parasgidd/avsdpll_3v3/Documents/pre layout final report.pdf

# PLL

# Final Report

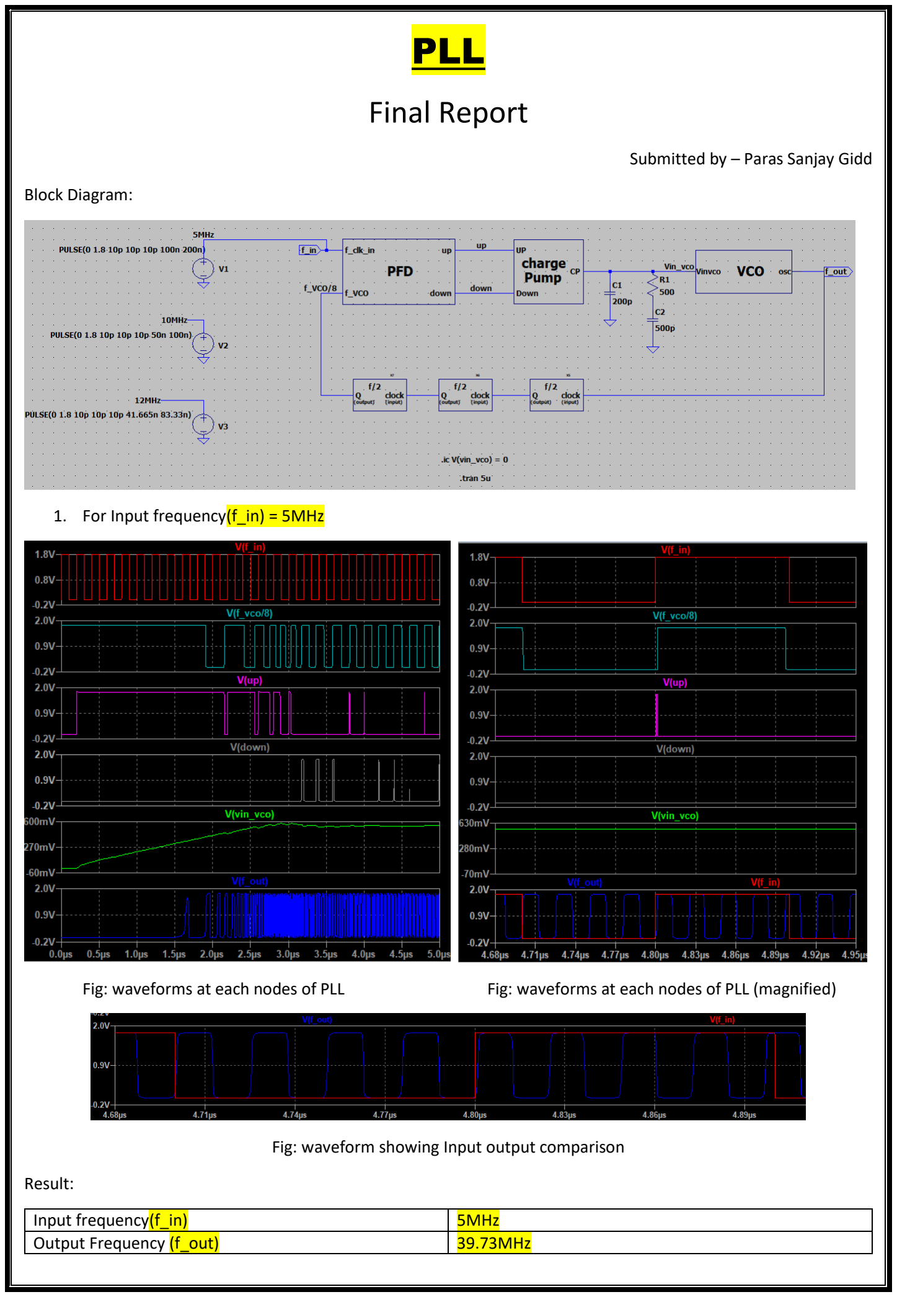
[picture p20: page 1]

Submitted by – Paras Sanjay Gidd

Block Diagram:

1. For Input frequency(f_in) = 5MHz
Fig: waveforms at each nodes of PLL | Fig: waveforms at each nodes of PLL (magnified)

Fig: waveform showing Input output comparison

Result:

Input frequency(f_in) | 5MHz
Output Frequency (f_out) | 39.73MHz

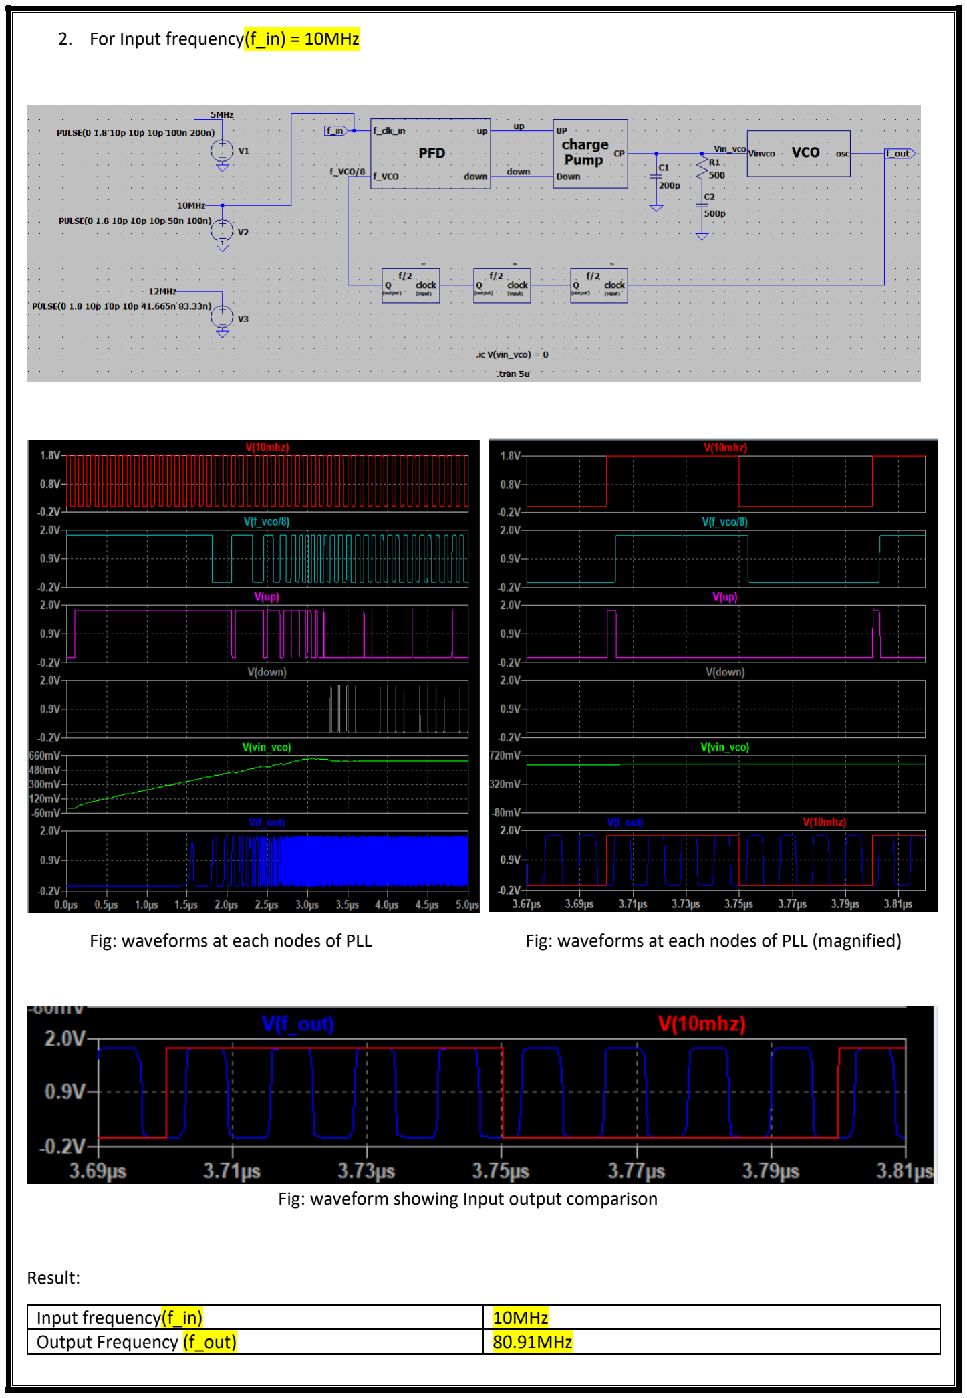
[picture p21: page 2]

2. For Input frequency(f_in) = 10MHz
Fig: waveforms at each nodes of PLL | Fig: waveforms at each nodes of PLL (magnified)

Fig: waveform showing Input output comparison

Result:

Input frequency(f_in) | 10MHz
Output Frequency (f_out) | 80.91MHz

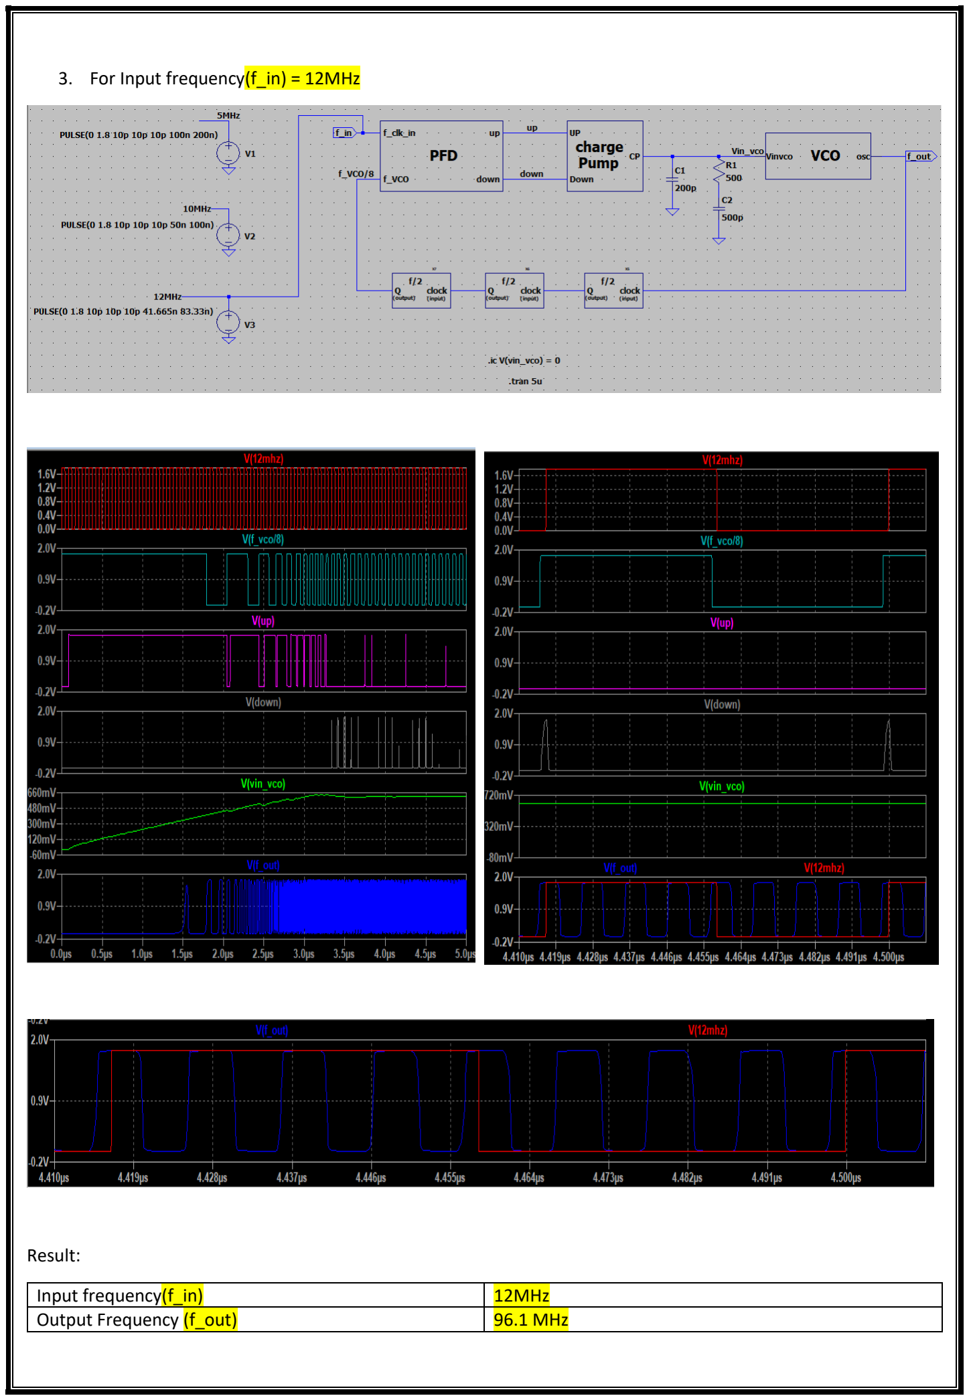
[picture p22: page 3]

3. For Input frequency(f_in) = 12MHz

Result:

Input frequency(f_in) | 12MHz
Output Frequency (f_out) | 96.1 MHz
