parasgidd/avsdpll_3v3/images/block_diagram.png

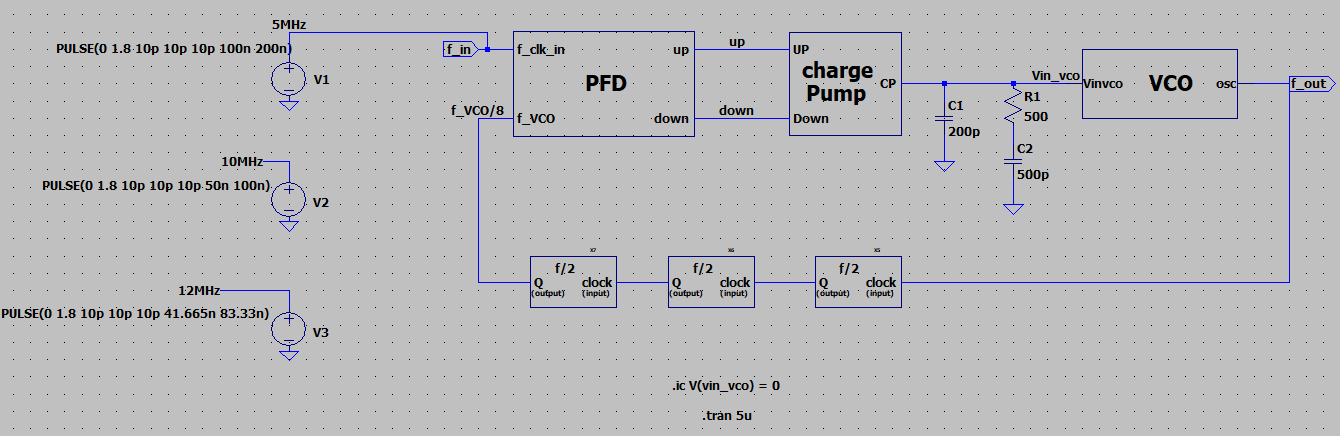
images/block_diagram.png
