parasgidd/avsdpll_3v3/images/LTS_op_wave_5Mh.jpg

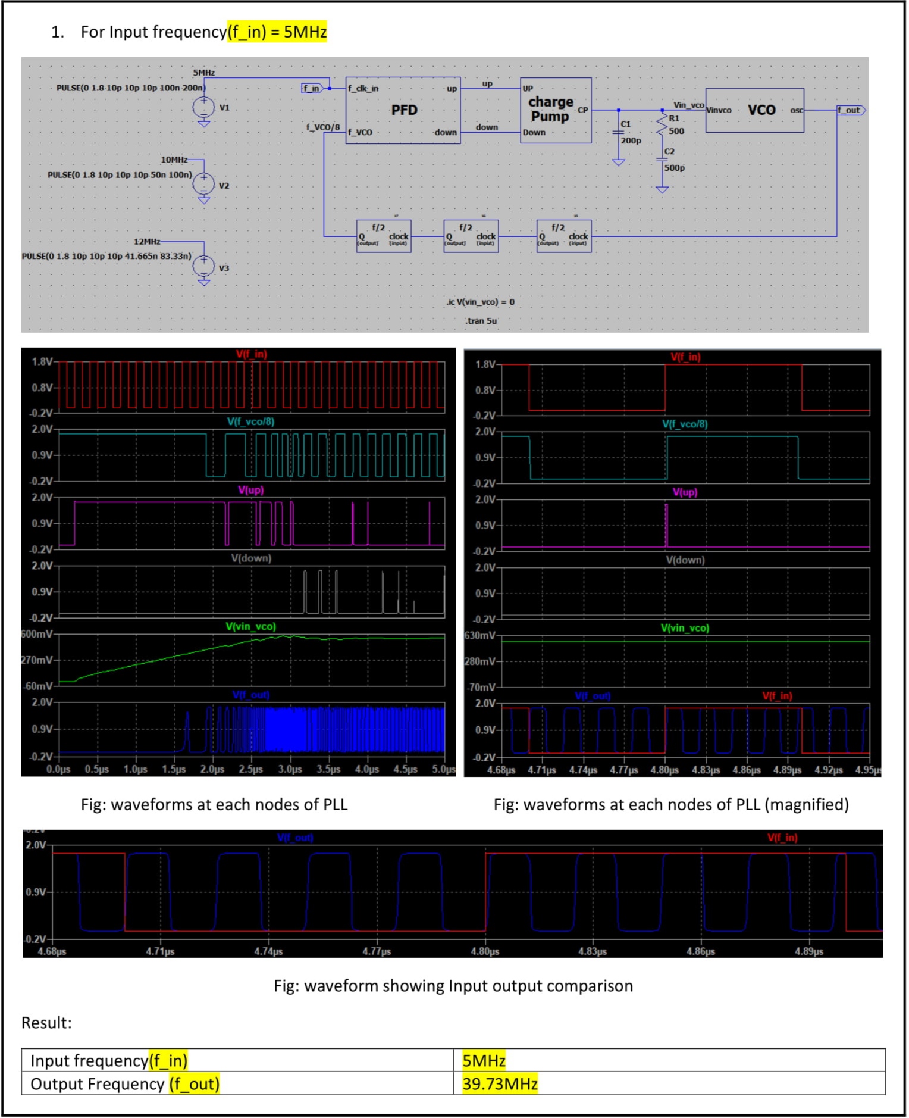
images/LTS_op_wave_5Mh.jpg
