parasgidd/avsdpll_3v3/images/LTS_op_wave_10Mh.jpg

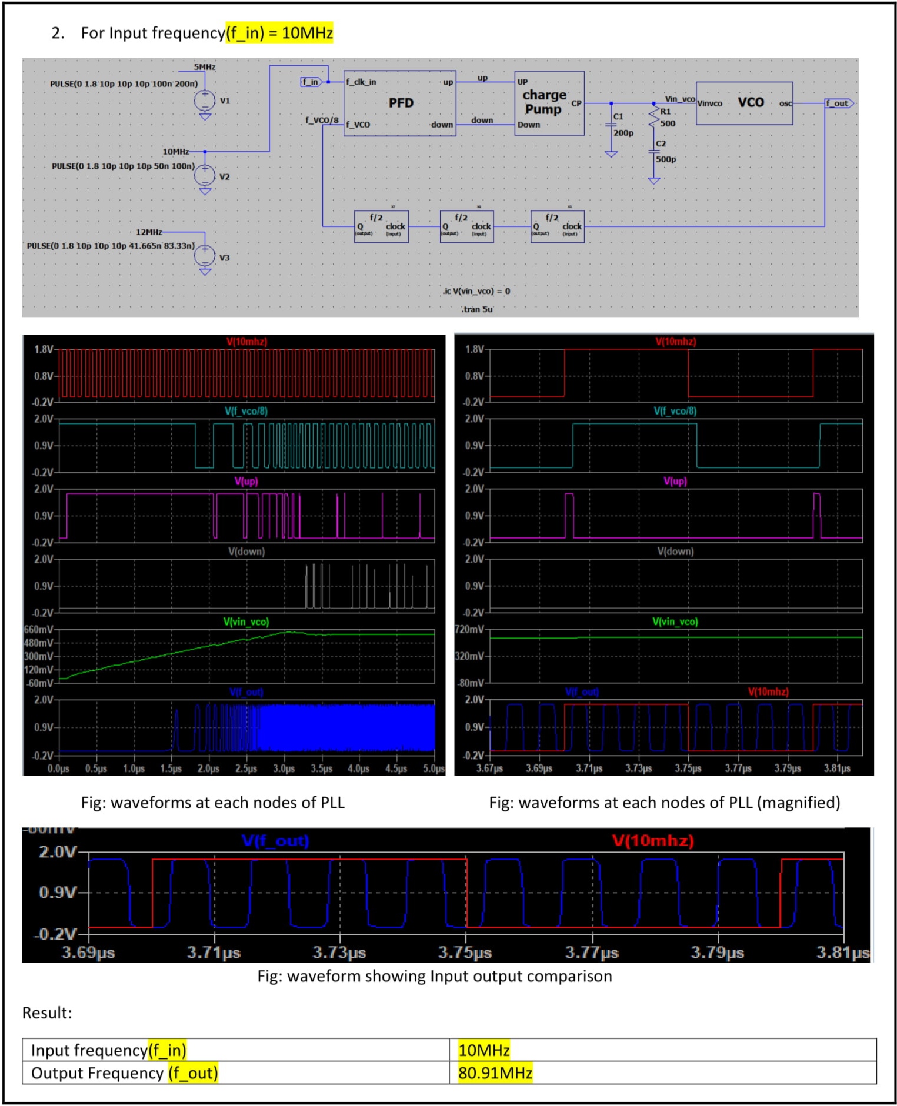
images/LTS_op_wave_10Mh.jpg
