parasgidd/avsdpll_3v3/images/LTS_op_wave_12Mh.jpg

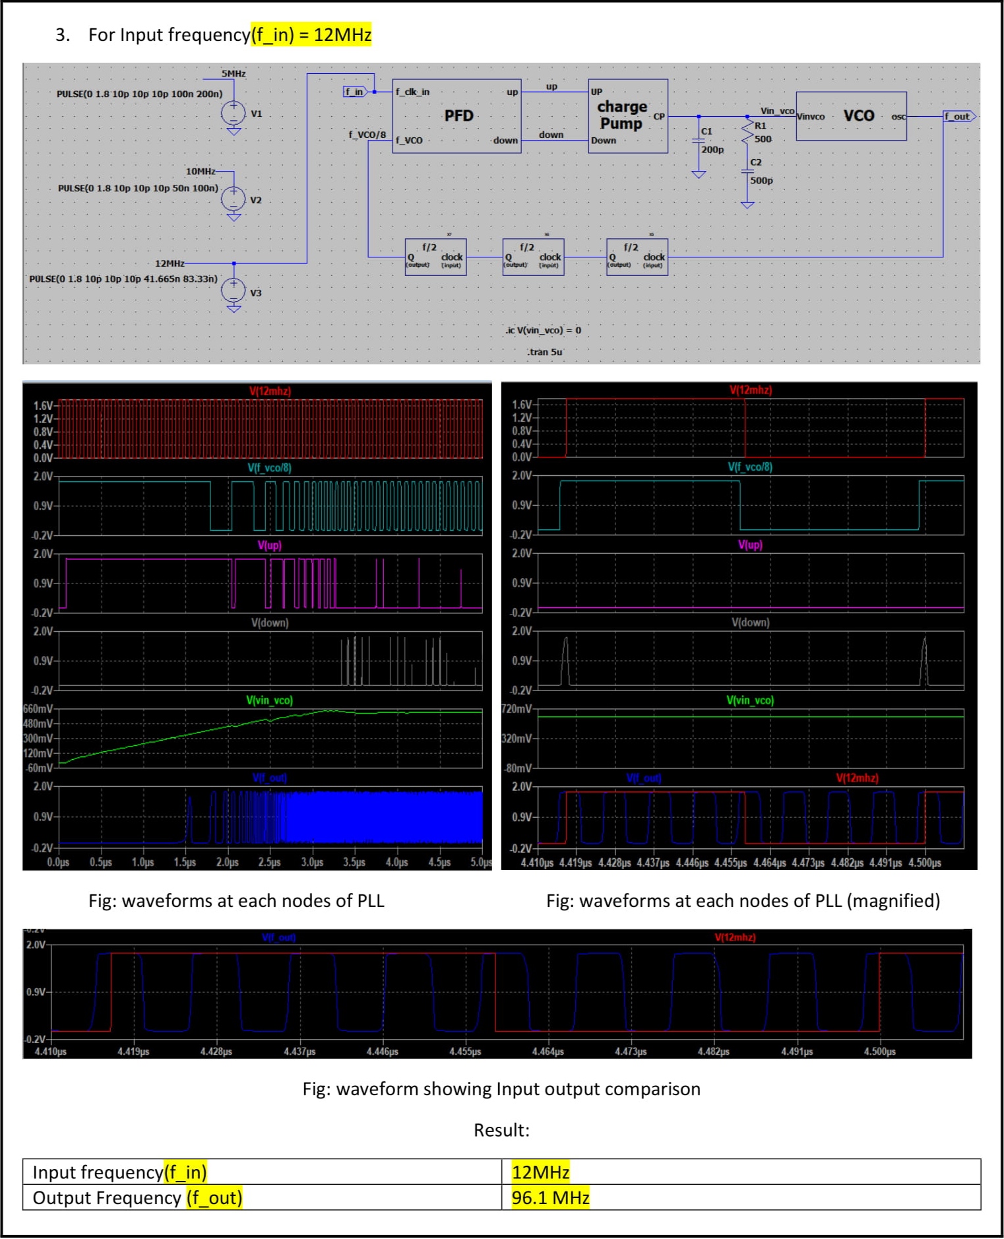
images/LTS_op_wave_12Mh.jpg
