parasgidd/avsdpll_3v3/images/waveforms_all_5M_z.png

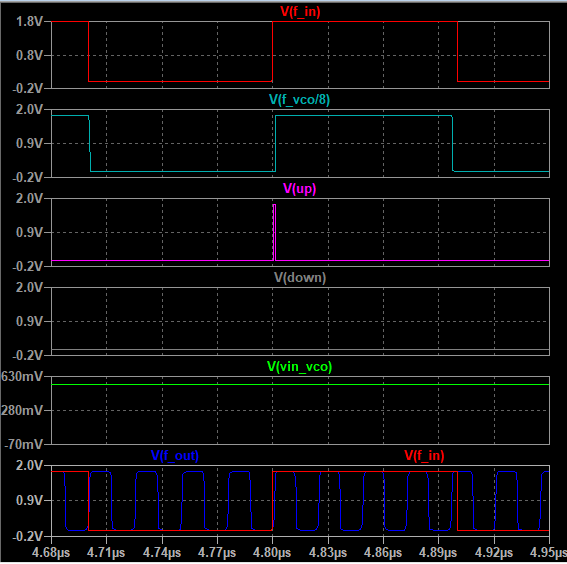
images/waveforms_all_5M_z.png
