parasgidd/avsdpll_3v3/Documents/avsdpll_3v3.pdf

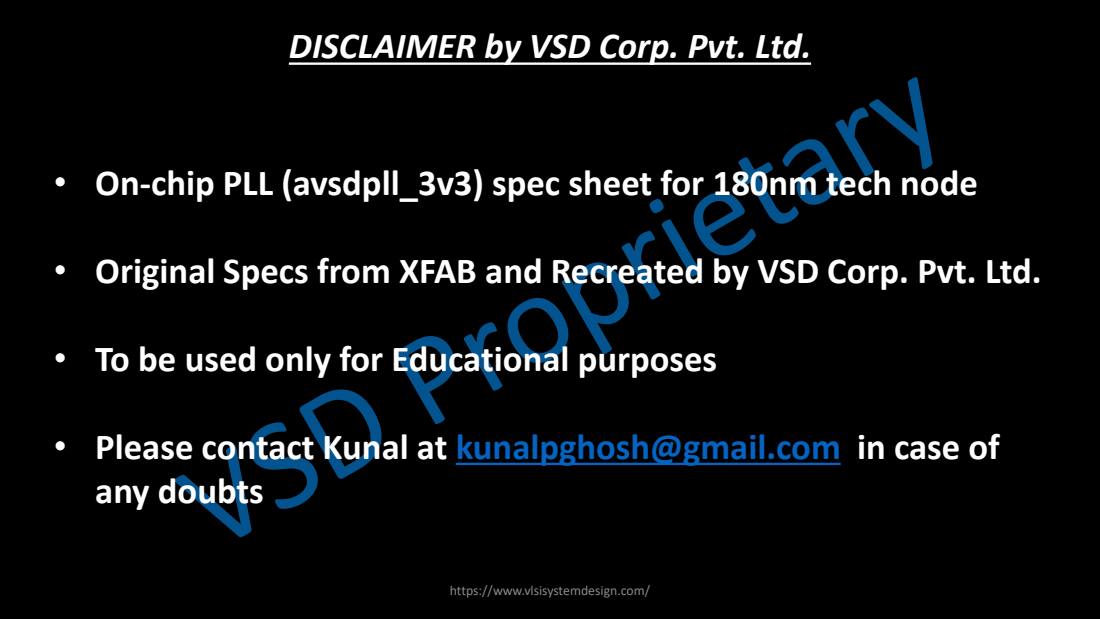
[picture p28: page 1]

DISCLAIMER by VSD Corp. Pvt. Ltd.

• On-chip PLL (avsdpll_3v3) spec sheet for 180nm tech node

• Original Specs from XFAB and Recreated by VSD Corp. Pvt. Ltd.

• To be used only for Educational purposes

• Please contact Kunal at kunalpghosh@gmail.com in case of
any doubts

https://www.vlsisystemdesign.com/

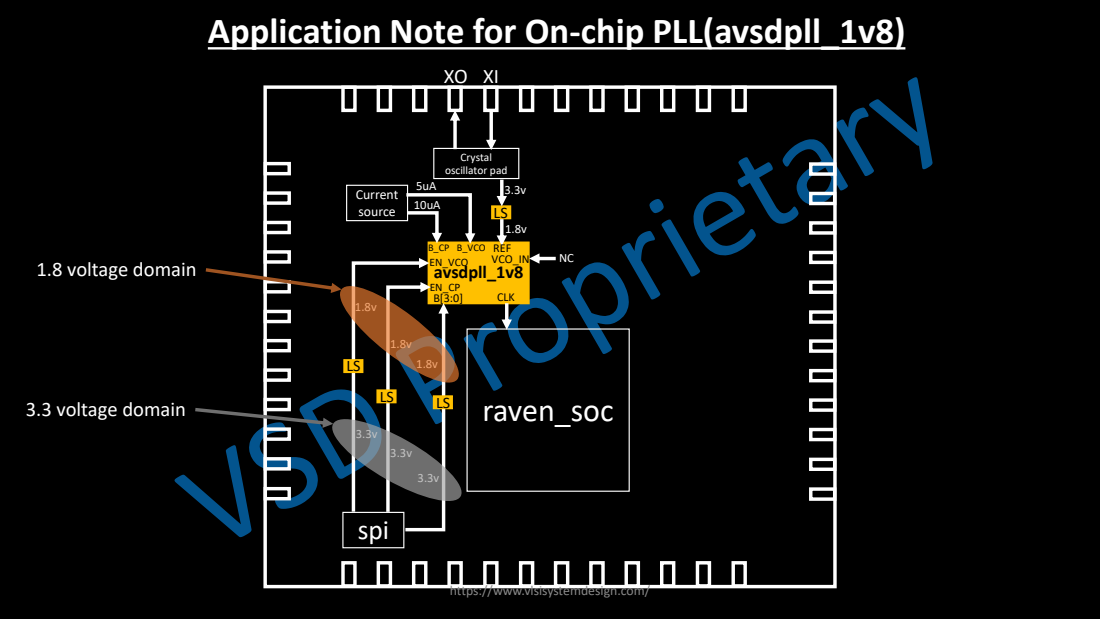
[picture p29: page 2]
avsdpll_1v8; Crystal oscillator pad; REF; CLK; raven_soc; spi; EN_VCO; Current source; B_CP B_VCO; VCO_IN; 3.3 voltage domain; 1.8 voltage domain

Application Note for On-chip PLL(avsdpll_1v8)

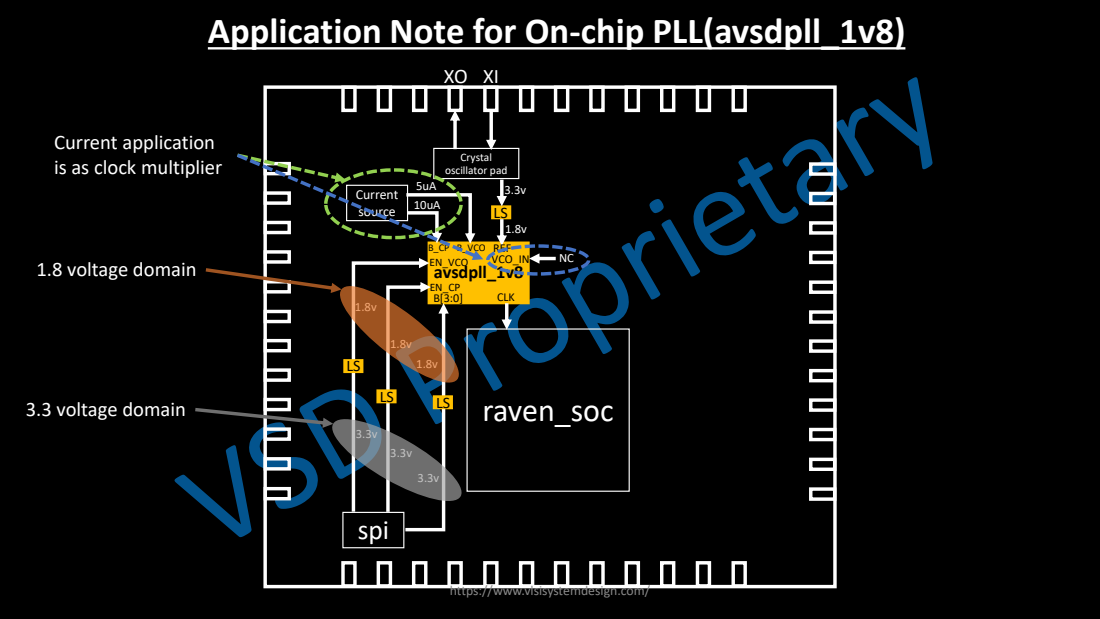
[picture p30: page 3]
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

Application Note for On-chip PLL(avsdpll_1v8)

Current application
is as clock multiplier

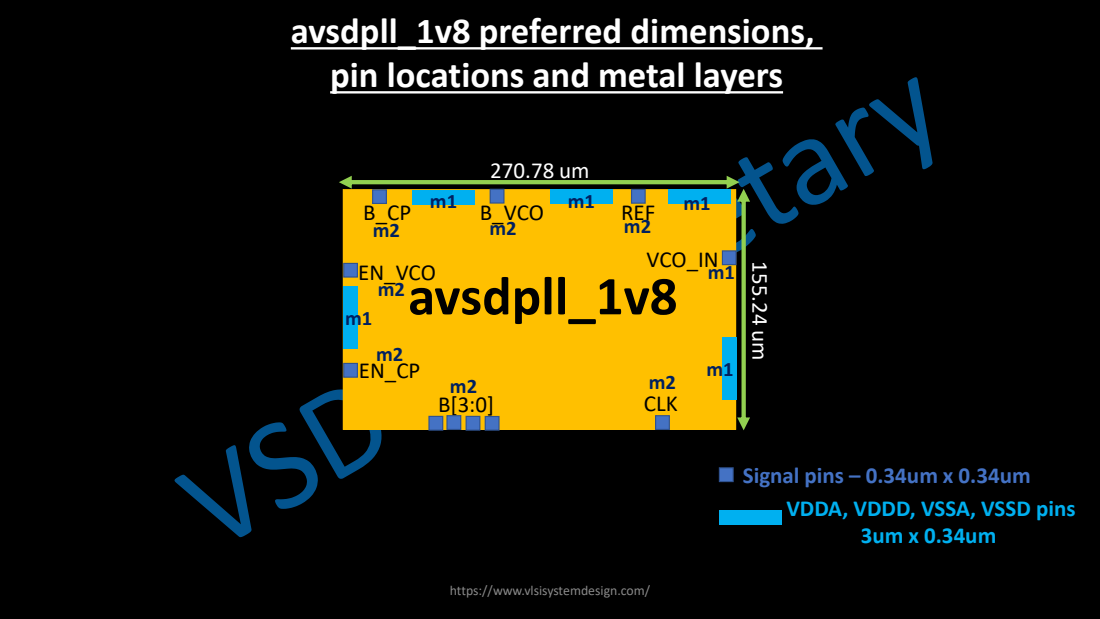
[picture p31: page 4]
avsdpll_1v8; REF; CLK; EN_VCO; B_VCO; VCO_IN

avsdpll_1v8 preferred dimensions,
pin locations and metal layers

Signal pins – 0.34um x 0.34um
VDDA, VDDD, VSSA, VSSD pins

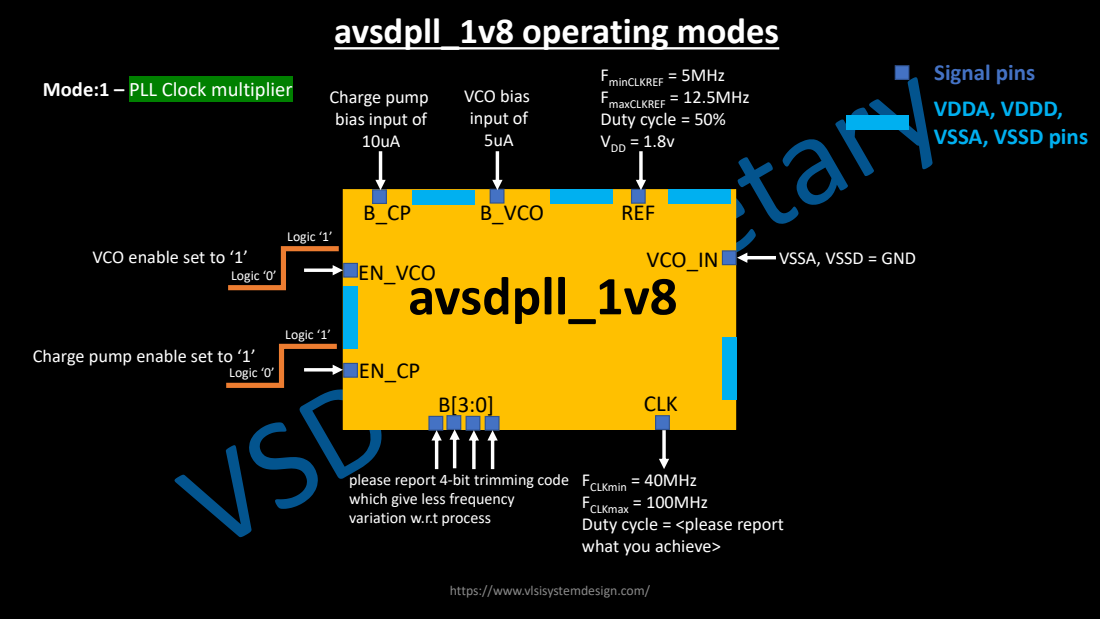
[picture p32: page 5]
avsdpll_1v8; REF; CLK; EN_VCO; B_VCO; VCO_IN; avsdpll_1v8 operating modes; FminCLKREF = 5MHz FmaxCLKREF = 12.5MHz Duty cycle = 50% VDD = 1.8v; VCO bias input of 5uA; Logic ‘0’; Logic ‘1’

Signal pins
VDDA, VDDD,
VSSA, VSSD pins

Mode:1 – PLL Clock multiplier

Charge pump
bias input of

VCO enable set to ‘1’

VSSA, VSSD = GND

Charge pump enable set to ‘1’

please report 4-bit trimming code
which give less frequency
variation w.r.t process

FCLKmin = 40MHz
FCLKmax = 100MHz
Duty cycle = <please report
what you achieve>

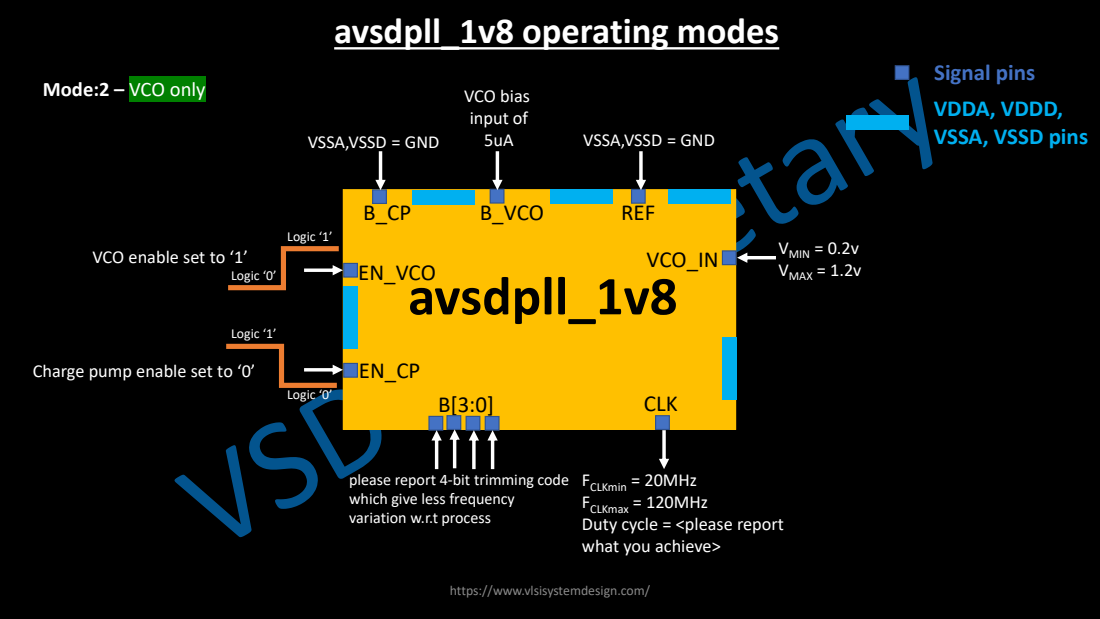
[picture p33: page 6]
avsdpll_1v8; REF; CLK; EN_VCO; B_VCO; VCO_IN; avsdpll_1v8 operating modes; Signal pins; VDDA, VDDD,; VSSA,VSSD = GND; VSSA, VSSD pins; VCO bias input of 5uA; VMIN = 0.2v VMAX = 1.2v; Logic ‘0’; Logic ‘1’

Mode:2 – VCO only

VSSA,VSSD = GND

VCO enable set to ‘1’

Charge pump enable set to ‘0’

please report 4-bit trimming code
which give less frequency
variation w.r.t process

FCLKmin = 20MHz
FCLKmax = 120MHz
Duty cycle = <please report
what you achieve>

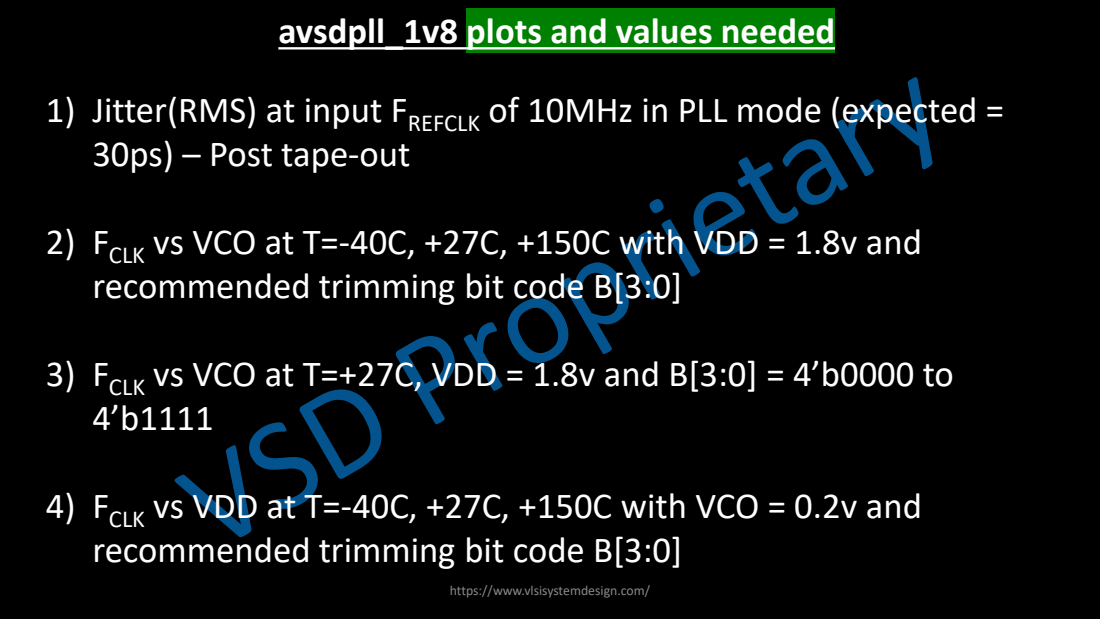
[picture p34: page 7]

avsdpll_1v8 plots and values needed

1) Jitter(RMS) at input FREFCLK of 10MHz in PLL mode (expected =
30ps) – Post tape-out

2) FCLK vs VCO at T=-40C, +27C, +150C with VDD = 1.8v and
recommended trimming bit code B[3:0]

3) FCLK vs VCO at T=+27C, VDD = 1.8v and B[3:0] = 4’b0000 to

4) FCLK vs VDD at T=-40C, +27C, +150C with VCO = 0.2v and

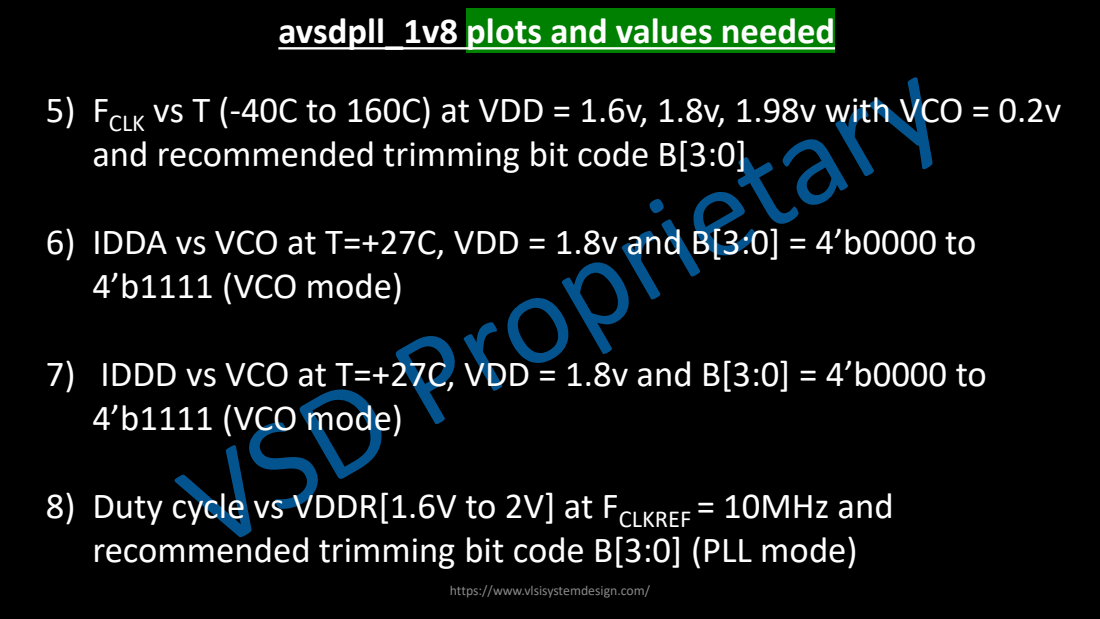
[picture p35: page 8]

avsdpll_1v8 plots and values needed

5) FCLK vs T (-40C to 160C) at VDD = 1.6v, 1.8v, 1.98v with VCO = 0.2v
and recommended trimming bit code B[3:0]

6) IDDA vs VCO at T=+27C, VDD = 1.8v and B[3:0] = 4’b0000 to
4’b1111 (VCO mode)

7) IDDD vs VCO at T=+27C, VDD = 1.8v and B[3:0] = 4’b0000 to

8) Duty cycle vs VDDR[1.6V to 2V] at FCLKREF = 10MHz and
recommended trimming bit code B[3:0] (PLL mode)
