parasgidd/avsdpll_3v3/LtSpice Simulation101/charge_pump.asc

M7: nmos4; nfet; l=180n w=180n
M8: nmos4; nfet; l=180n w=180n
M12: pmos4; pfet; l=180n w=540n
M14: pmos4; pfet; l=180n w=540n
M15: nmos4; nfet; l=180n w=180n
M16: nmos4; nfet; l=180n w=180n
M17: nmos4; nfet; l=180n w=180n
M18: nmos4; nfet; l=180n w=180n
M19: nmos4; nfet; l=180n w=180n
M20: nmos4; nfet; l=180n w=15u
M21: pmos4; pfet; l=180n w=540n
M22: pmos4; pfet; l=180n w=540n
M23: pmos4; pfet; l=180n w=540n
M24: pmos4; pfet; l=180n w=540n
M25: pmos4; pfet; l=180n w=540n
M26: pmos4; pfet; l=180n w=45u
V1: voltage; 1.8
Named nets: UP_bar, DOWN_bar, CP, Down, VDD, GND, UP, 0
.lib osu018.lib
