parasgidd/avsdpll_3v3/LtSpice Simulation101/cs_inv.asc

C1: cap; 1f
M1: nmos4; nfet; l=180n w=360n
M2: nmos4; nfet; l=180n w=360n
M3: pmos4; pfet; l=180n w=720n
M4: pmos4; pfet; l=180n w=720n
V1: voltage; 1.8
Named nets: 0, VDD, In, Vp, Vn, Out
.lib osu018.lib
model parasitic C
(important)
