parasgidd/avsdpll_3v3/LtSpice Simulation101/freq_div_2.asc

M1: nmos4; nfet; l=180n w=180n
M2: pmos4; pfet; l=180n w=540n
M3: pmos4; pfet; l=180n w=540n
M4: nmos4; nfet; l=180n w=180n
M5: nmos4; nfet; l=180n w=180n
M6: pmos4; pfet; l=180n w=540n
M7: nmos4; nfet; l=180n w=180n
M8: pmos4; pfet; l=180n w=540n
M9: nmos4; nfet; l=180n w=180n
M10: pmos4; pfet; l=180n w=540n
M11: nmos4; nfet; l=180n w=180n
M12: pmos4; pfet; l=180n w=540n
M13: nmos4; nfet; l=180n w=180n
M14: pmos4; pfet; l=180n w=540n
M15: nmos4; nfet; l=180n w=180n
M16: pmos4; pfet; l=180n w=540n
M17: nmos4; nfet; l=180n w=180n
M18: pmos4; pfet; l=180n w=540n
VDD: voltage; 1.8
Named nets: 0, VDD, D, clock_b, clock, Q_bar, Q
.lib osu018.lib
