parasgidd/avsdpll_3v3/LtSpice Simulation101/inv101.asc

M1: nmos4; nfet; l=180n w=180n
M2: pmos4; pfet; l=180n w=360n
Named nets: out, in, VDD, GND
.lib osu018.lib
W=180nm, L=180nm
W=360nm, L=180nm
