parasgidd/avsdpll_3v3/LtSpice Simulation101/inv_20_10.asc

M1: nmos4; nfet; l=180n w=360n
M2: pmos4; pfet; l=180n w=720n
V1: voltage; 1.8
Named nets: In, Out, 0
.lib osu018.lib
