parasgidd/avsdpll_3v3/LtSpice Simulation101/nand301.asc

M1: nmos4; nfet; l=180n w=540n
M2: pmos4; pfet; l=180n w=360n
M3: pmos4; pfet; l=180n w=360n
M4: nmos4; nfet; l=180n w=540n
M5: nmos4; nfet; l=180n w=540n
M6: pmos4; pfet; l=180n w=360n
Named nets: out, in1, VDD, GND, in2, in3
.lib osu018.lib
W=540n  L=180n
W=360nm, L=180nm
W=540n  L=180n
W=360nm, L=180nm
W=540n  L=180n
W=360n  L=180n
3 Input NAND
 
PMOS >>> 2:1
NMOS >>> 3:1
