parasgidd/avsdpll_3v3/LtSpice Simulation101/nand401.asc

M1: nmos4; nfet; l=180n w=720n
M2: pmos4; pfet; l=180n w=360n
M3: pmos4; pfet; l=180n w=360n
M4: nmos4; nfet; l=180n w=720n
M5: nmos4; nfet; l=180n w=720n
M6: pmos4; pfet; l=180n w=360n
M7: nmos4; nfet; l=180n w=720n
M8: pmos4; pfet; l=180n w=360n
Named nets: out, in1, VDD, GND, in2, in3, in4
.lib osu018.lib
W=720n  L=180n
W=360nm, L=180nm
W=720n  L=180n
W=360nm, L=180nm
W=720n  L=180n
W=360n  L=180n
4 Input NAND
 
PMOS >>> 2:1
NMOS >>> 4:1
W=720n  L=180n
