parasgidd/avsdpll_3v3/LtSpice Simulation101/vco_19_16.asc

M7: nmos4; nfet; l=180n w=360n
M8: pmos4; pfet; l=180n w=1800n
R1: res; 1
U22: INV_20_10
V1: voltage; 1.8
X3: CS_inv
X16: CS_inv
X17: CS_inv
X18: CS_inv
X19: CS_inv
X20: CS_inv
X21: CS_inv
Named nets: Vinvco, 0, VDD, Vp, Vn, osc, osc_fb, n1, GND, Osc
.lib osu018.lib
