parasgidd/avsdpll_3v3/LtSpice Simulation101/Final_PLL_501.asc

C1: cap; 200p
C2: cap; 500p
R1: res; 500
V1: voltage; PULSE(0 1.8 10p 10p 10p 100n 200n)
V2: voltage; PULSE(0 1.8 10p 10p 10p 50n 100n)
V3: voltage; PULSE(0 1.8 10p 10p 10p 41.665n 83.33n)
X1: pfd_501
X2: charge_pump
X3: VCO_19_16
X5: freq_div_2
X6: freq_div_2
X7: freq_div_2
Named nets: f_out, f_in, 0, 5MHz, 10MHz, 12MHz, up, down, Vin_vco, f_VCO/8
.tran 5u
.ic V(vin_vco) = 0
