parasgidd/avsdpll_3v3/LtSpice Simulation101/pfd_501.asc

V1: voltage; pulse 0 1 0 100p 100p 5n 10n
V2: voltage; pulse 0 1 2n 100p 100p 5n 9n
V3: voltage; 1.8
X1: nand101
X2: nand101
X3: nand101
X4: nand101
X5: nand101
X6: nand101
X7: inv101
X8: inv101
X9: inv101
X10: inv101
X11: inv101
X12: inv101
X13: nand301
X14: nand301
X15: inv101
X16: nand401
X17: inv101
Named nets: f_clk_in, f_VCO, up, down, 0, vddd
.tran 50n
