parasgidd/avsdpll_3v3/Post Layout Simulation/PLL/pll.sp

*final PLL101 from layout
* SPICE3 file created from pll.ext - technology: scmos


.include osu018.lib
.option scale=0.1u

************* charge pump ******************

M1048 a_290_206# dn gnd gnd nfet w=3 l=2
+  ad=0 pd=0 as=0 ps=0
M1017 a_289_251# a_280_251# vdd w_251_224# pfet w=6 l=2
+  ad=342 pd=150 as=0 ps=0

****************************


.option scale=0.1u

M1000 a_264_214# dn a_257_230# w_251_224# pfet w=8 l=2
+  ad=80 pd=52 as=40 ps=26
M1001 gnd a_48_n122# a_68_n124# gnd nfet w=3 l=2
+  ad=1404 pd=998 as=43 ps=32
M1002 a_102_19# a_78_19# gnd gnd nfet w=3 l=2
+  ad=23 pd=20 as=0 ps=0
M1003 vdd a_48_36# a_43_86# vdd pfet w=11 l=2
+  ad=3137 pd=1652 as=88 ps=38
M1004 a_127_406# a_102_336# gnd gnd nfet w=9 l=2
+  ad=81 pd=36 as=0 ps=0
M1005 vdd a_394_n124# a_384_n122# w_3_n133# pfet w=8 l=2
+  ad=0 pd=0 as=80 ps=36
M1006 a_66_299# a_43_336# vdd vdd pfet w=11 l=2
+  ad=88 pd=38 as=0 ps=0
M1007 a_58_n122# a_55_n108# a_48_n122# w_3_n133# pfet w=8 l=2
+  ad=80 pd=36 as=112 ps=60
M1008 vdd a_317_136# a_355_101# vdd pfet w=6 l=2
+  ad=0 pd=0 as=18 ps=18
M1009 a_318_80# a_316_78# a_316_57# gnd nfet w=3 l=2
+  ad=9 pd=12 as=23 ps=20
M1010 vdd vdd gnd gnd nfet w=3 l=2
+  ad=3473 pd=2920 as=0 ps=0
M1011 a_221_n122# a_218_n79# a_211_n122# gnd nfet w=3 l=2
+  ad=40 pd=30 as=62 ps=48
M1012 a_135_228# a_66_299# gnd gnd nfet w=13 l=2
+  ad=52 pd=34 as=0 ps=0
M1013 a_66_123# a_43_86# vdd vdd pfet w=11 l=2
+  ad=88 pd=38 as=0 ps=0
M1014 a_68_n124# a_55_n79# a_36_n124# gnd nfet w=3 l=2
+  ad=0 pd=0 as=46 ps=34
M1015 a_355_59# a_316_57# a_316_36# vdd pfet w=6 l=2
+  ad=18 pd=18 as=30 ps=22
M1016 a_264_251# up vdd w_251_224# pfet w=8 l=2
+  ad=80 pd=52 as=0 ps=0

M1018 a_231_n124# a_218_n108# a_199_n124# w_3_n133# pfet w=8 l=2
+  ad=88 pd=38 as=96 ps=40
M1019 gnd cp a_318_38# gnd nfet w=3 l=2
+  ad=0 pd=0 as=9 ps=12
M1020 a_318_101# a_316_99# a_316_78# gnd nfet w=3 l=2
+  ad=9 pd=12 as=23 ps=20
M1021 vdd a_317_136# a_355_122# vdd pfet w=6 l=2
+  ad=0 pd=0 as=18 ps=18
M1022 a_102_336# a_78_336# gnd gnd nfet w=3 l=2
+  ad=23 pd=20 as=0 ps=0
M1023 gnd a_362_n124# a_218_n79# gnd nfet w=3 l=2
+  ad=0 pd=0 as=31 ps=24
M1024 a_74_227# a_110_121# a_102_229# gnd nfet w=6 l=2
+  ad=36 pd=24 as=48 ps=28
M1025 a_43_336# a_18_336# vdd vdd pfet w=11 l=2
+  ad=88 pd=38 as=0 ps=0
M1026 a_355_80# a_316_78# a_316_57# vdd pfet w=6 l=2
+  ad=18 pd=18 as=30 ps=22
M1027 a_172_n122# a_218_n108# a_211_n122# gnd nfet w=3 l=2
+  ad=86 pd=64 as=0 ps=0
M1028 a_110_121# a_43_336# vdd vdd pfet w=11 l=2
+  ad=198 pd=80 as=0 ps=0
M1029 a_280_214# vdd a_264_214# w_251_224# pfet w=8 l=2
+  ad=40 pd=26 as=0 ps=0
M1030 a_43_86# a_48_36# a_43_17# gnd nfet w=6 l=2
+  ad=36 pd=24 as=48 ps=28
M1031 vdd a_68_n124# a_58_n122# w_3_n133# pfet w=8 l=2
+  ad=0 pd=0 as=0 ps=0
M1032 gnd cp a_318_59# gnd nfet w=3 l=2
+  ad=0 pd=0 as=9 ps=12
M1033 dn a_48_36# vdd vdd pfet w=11 l=2
+  ad=55 pd=32 as=0 ps=0
M1034 a_18_336# fin gnd gnd nfet w=3 l=2
+  ad=23 pd=20 as=0 ps=0
M1035 a_66_299# a_74_227# a_66_229# gnd nfet w=6 l=2
+  ad=36 pd=24 as=48 ps=28
M1036 vdd a_317_136# a_355_38# vdd pfet w=6 l=2
+  ad=0 pd=0 as=18 ps=18
M1037 a_355_101# a_316_99# a_316_78# vdd pfet w=6 l=2
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
C222 a_374_n122# gnd 0.99fF
C223 a_362_n124# gnd 0.68fF
C224 a_335_n122# gnd 0.50fF
C225 a_218_n108# gnd 0.81fF
C226 a_231_n124# gnd 0.66fF
C227 a_221_n122# gnd 0.23fF
C228 a_218_n79# gnd 1.79fF
C229 a_211_n122# gnd 0.99fF
C230 a_199_n124# gnd 0.68fF
C231 a_172_n122# gnd 0.50fF
C232 a_55_n108# gnd 0.81fF
C233 a_68_n124# gnd 0.66fF
C234 a_58_n122# gnd 0.23fF
C235 a_55_n79# gnd 1.79fF
C236 a_48_n122# gnd 0.99fF
C237 a_36_n124# gnd 0.68fF
C238 a_9_n122# gnd 0.50fF
C239 fout gnd 2.31fF
C240 a_316_36# gnd 0.48fF
C241 a_316_57# gnd 0.49fF
C242 a_316_78# gnd 0.25fF
C243 a_102_19# gnd 0.73fF
C244 a_78_19# gnd 0.78fF
C245 a_48_36# gnd 1.59fF
C246 a_18_19# gnd 0.83fF
C247 fvco_8 gnd 1.97fF
C248 a_316_99# gnd 0.47fF
C249 a_316_19# gnd 0.77fF
C250 a_317_136# gnd 0.51fF
C251 a_74_121# gnd 0.80fF
C252 a_290_206# gnd 0.23fF
C253 a_280_214# gnd 0.27fF
C254 a_264_214# gnd 0.22fF
C255 cp gnd 1.59fF
C256 dn gnd 1.24fF
C257 a_289_251# gnd 0.08fF
C258 a_264_251# gnd 0.15fF
C259 a_280_251# gnd 0.26fF
C260 a_43_86# gnd 1.99fF
C261 a_66_123# gnd 1.82fF
C262 a_74_227# gnd 0.80fF
C263 up gnd 1.05fF
C264 a_110_121# gnd 2.65fF
C265 a_66_299# gnd 1.69fF
C266 a_102_336# gnd 0.73fF
C267 a_78_336# gnd 0.78fF
C268 a_43_336# gnd 1.80fF
C269 fin gnd 0.51fF
C270 a_48_392# gnd 1.59fF
C271 a_18_336# gnd 0.83fF
C272 w_3_n133# gnd 9.27fF
C273 w_251_224# gnd 3.65fF


****************************
C1 cp 0 25p
C2 N003 0 55p
R1 cp N003 500

********************************

V1 fin 0 PULSE 0 1.8 1n 60p 60p 100n 200n
V2 vdd gnd 1.8

********************************


.tran .1n 10u uic
*.tran .1n 25u 24.5u uic
*.ic V(vin_vco) = 0
.control
run
plot V(fin)+8 V(fvco_8)+8 V(up)+6 V(dn)+4 V(cp)+2 V(fout)
plot V(up)+4 V(dn)+2 V(fin) V(fvco_8)
plot V(up)+4 V(dn)+2 V(fin) V(fout)
plot V(cp)

*plot V(N002)
*plot V(Vin_vco)
*plot V(f_out)
.endc
.end
