parasgidd/avsdpll_3v3/Post Layout Simulation/PLL/pllv2.sp

*final PLL101 from layout

* SPICE3 file created from pfd_cp101.ext - technology: scmos


.include osu018.lib




.option scale=0.1u



M1000 a_264_214# dn a_257_230# w_251_224# pfet w=8 l=2
+  ad=80 pd=52 as=40 ps=26
M1001 a_102_19# a_78_19# gnd gnd nfet w=3 l=2
+  ad=23 pd=20 as=1404 ps=998
M1002 vdd a_48_36# a_43_86# vdd pfet w=11 l=2
+  ad=3137 pd=1652 as=88 ps=38
M1003 a_127_406# a_102_336# gnd gnd nfet w=9 l=2
+  ad=81 pd=36 as=0 ps=0
M1004 a_66_299# a_43_336# vdd vdd pfet w=11 l=2
+  ad=88 pd=38 as=0 ps=0
M1005 vdd a_23_n117# fvco_8 vdd pfet w=8 l=2
+  ad=0 pd=0 as=56 ps=30
M1006 a_186_n117# a_205_n101# a_159_n115# gnd nfet w=3 l=2
+  ad=46 pd=34 as=86 ps=64
M1007 vdd vdd gnd gnd nfet w=3 l=2
+  ad=3473 pd=2920 as=0 ps=0
M1008 vdd a_205_n72# a_322_n115# vdd pfet w=8 l=2
+  ad=0 pd=0 as=176 ps=76
M1009 a_186_n117# a_205_n72# a_159_n115# vdd pfet w=8 l=2
+  ad=96 pd=40 as=176 ps=76
M1010 a_135_228# a_66_299# gnd gnd nfet w=13 l=2
+  ad=52 pd=34 as=0 ps=0
M1011 a_66_123# a_43_86# vdd vdd pfet w=11 l=2
+  ad=88 pd=38 as=0 ps=0
M1012 a_55_n117# a_42_n101# a_23_n117# vdd pfet w=8 l=2
+  ad=88 pd=38 as=96 ps=40
M1013 a_264_251# up vdd w_251_224# pfet w=8 l=2
+  ad=80 pd=52 as=0 ps=0
M1015 a_208_n115# a_205_n101# a_198_n115# vdd pfet w=8 l=2
+  ad=80 pd=36 as=112 ps=60
M1016 gnd cp a_548_n53# gnd nfet w=3 l=2
+  ad=0 pd=0 as=9 ps=12
M1017 a_102_336# a_78_336# gnd gnd nfet w=3 l=2
+  ad=23 pd=20 as=0 ps=0
M1018 a_74_227# a_110_121# a_102_229# gnd nfet w=6 l=2
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
M1111 vdd a_66_123# a_110_121# vdd pfet w=11 l=2
+  ad=0 pd=0 as=0 ps=0
M1112 vdd a_74_227# a_66_299# vdd pfet w=11 l=2
+  ad=0 pd=0 as=0 ps=0
M1113 vdd a_551_n95# a_611_n93# vdd pfet w=6 l=2
+  ad=0 pd=0 as=18 ps=18
M1114 dn a_48_36# gnd gnd nfet w=3 l=2
+  ad=23 pd=20 as=0 ps=0
M1115 vdd a_66_123# a_48_36# vdd pfet w=11 l=2
+  ad=0 pd=0 as=0 ps=0
M1116 a_18_336# fin vdd vdd pfet w=11 l=2
+  ad=55 pd=32 as=0 ps=0
M1117 a_611_n93# a_609_n95# a_588_n95# vdd pfet w=6 l=2
+  ad=0 pd=0 as=30 ps=22
M1118 vdd a_74_121# a_66_123# vdd pfet w=11 l=2
+  ad=0 pd=0 as=0 ps=0
M1119 cp gnd a_289_251# w_251_224# pfet w=8 l=2
+  ad=40 pd=26 as=0 ps=0
M1120 vdd a_205_n72# a_205_n101# vdd pfet w=8 l=2
+  ad=0 pd=0 as=56 ps=30
M1121 a_23_n117# a_42_n72# a_n4_n115# vdd pfet w=8 l=2
+  ad=0 pd=0 as=176 ps=76
M1122 a_48_392# a_102_336# vdd vdd pfet w=11 l=2
+  ad=0 pd=0 as=0 ps=0
M1123 a_322_n115# a_368_n101# a_361_n115# gnd nfet w=3 l=2
+  ad=86 pd=64 as=0 ps=0
M1124 gnd a_205_n72# a_205_n101# gnd nfet w=3 l=2
+  ad=0 pd=0 as=31 ps=24
M1125 up a_48_392# vdd vdd pfet w=11 l=2
+  ad=55 pd=32 as=0 ps=0
M1126 a_n4_n115# a_42_n72# a_35_n115# vdd pfet w=8 l=2
+  ad=0 pd=0 as=0 ps=0
M1127 a_48_36# a_102_19# vdd vdd pfet w=11 l=2
+  ad=0 pd=0 as=0 ps=0
M1128 vdd a_48_392# a_43_336# vdd pfet w=11 l=2
+  ad=0 pd=0 as=0 ps=0
M1129 vdd a_551_n95# a_590_n93# vdd pfet w=6 l=2
+  ad=0 pd=0 as=18 ps=18
M1130 gnd a_23_n117# fvco_8 gnd nfet w=3 l=2
+  ad=0 pd=0 as=31 ps=24
M1131 a_590_n93# a_588_n95# a_567_n95# vdd pfet w=6 l=2
+  ad=0 pd=0 as=30 ps=22
M1132 gnd cp a_551_n95# gnd nfet w=3 l=2
+  ad=0 pd=0 as=23 ps=20
M1133 gnd a_361_n115# a_381_n117# gnd nfet w=3 l=2
+  ad=0 pd=0 as=0 ps=0
M1134 a_43_410# a_18_336# gnd gnd nfet w=6 l=2
+  ad=0 pd=0 as=0 ps=0
M1135 a_280_214# gnd a_264_214# gnd nfet w=3 l=2
+  ad=23 pd=20 as=0 ps=0
M1136 vdd a_551_n95# a_632_n93# vdd pfet w=6 l=2
+  ad=0 pd=0 as=0 ps=0
M1137 vdd fvco_8 a_n4_n115# vdd pfet w=8 l=2
+  ad=0 pd=0 as=0 ps=0
M1138 a_48_392# a_110_121# a_138_406# gnd nfet w=9 l=2
+  ad=54 pd=30 as=0 ps=0
M1139 a_322_n115# fout a_361_n115# vdd pfet w=8 l=2
+  ad=0 pd=0 as=0 ps=0
M1140 gnd a_205_n72# a_322_n115# gnd nfet w=3 l=2
+  ad=0 pd=0 as=0 ps=0
M1141 a_18_19# fvco_8 vdd vdd pfet w=11 l=2
+  ad=55 pd=32 as=0 ps=0
M1142 vdd a_35_n115# a_55_n117# vdd pfet w=8 l=2
+  ad=0 pd=0 as=0 ps=0
M1143 gnd gnd vdd w_251_224# pfet w=7 l=2
+  ad=4683 pd=4118 as=0 ps=0
M1144 a_74_227# a_66_299# vdd vdd pfet w=11 l=2
+  ad=0 pd=0 as=0 ps=0
M1145 a_78_19# a_43_86# gnd gnd nfet w=3 l=2
+  ad=23 pd=20 as=0 ps=0
M1146 gnd a_529_n95# fout gnd nfet w=3 l=2
+  ad=0 pd=0 as=23 ps=20
M1147 a_78_336# a_43_336# vdd vdd pfet w=11 l=2
+  ad=55 pd=32 as=0 ps=0
M1148 a_349_n117# fout a_322_n115# vdd pfet w=8 l=2
+  ad=0 pd=0 as=0 ps=0
M1149 a_110_121# a_43_86# a_147_228# gnd nfet w=13 l=2
+  ad=130 pd=46 as=0 ps=0
M1150 a_74_121# a_66_123# vdd vdd pfet w=11 l=2
+  ad=0 pd=0 as=0 ps=0
M1151 a_349_n117# a_368_n101# a_322_n115# gnd nfet w=3 l=2
+  ad=0 pd=0 as=0 ps=0
M1152 a_290_206# a_280_214# a_290_206# gnd nfet w=3 l=2
+  ad=0 pd=0 as=0 ps=0
M1153 gnd fout a_368_n101# gnd nfet w=3 l=2
+  ad=0 pd=0 as=31 ps=24
C0 vdd a_361_n115# 0.38fF
C1 a_322_n115# a_349_n117# 0.02fF
C2 vdd a_48_392# 0.45fF
C3 cp a_551_n95# 0.13fF
C4 vdd a_567_n95# 0.19fF
C5 a_368_n101# a_371_n115# 0.08fF
C6 a_529_n95# fout 0.07fF
C7 vdd a_45_n115# 0.13fF
C8 a_48_392# a_66_299# 0.10fF
C9 a_567_n95# a_546_n95# 0.07fF
C10 vdd a_35_n115# 0.38fF
C11 a_159_n115# a_186_n117# 0.02fF
C12 vdd a_48_36# 0.45fF
C13 a_66_123# a_43_86# 0.01fF
C14 up a_264_251# 0.07fF
C15 vdd cp 0.05fF
C16 w_251_224# dn 0.07fF
C17 a_43_336# a_66_123# 0.25fF
C18 a_102_19# a_66_123# 0.03fF
C19 a_289_251# cp 0.07fF
C20 a_546_n95# cp 0.20fF
C21 a_n4_n115# a_23_n117# 0.02fF
C22 a_23_n117# fvco_8 0.07fF
C23 fvco_8 a_18_19# 0.05fF
C24 a_322_n115# a_361_n115# 0.06fF
C25 vdd fout 0.42fF
C26 vdd fin 0.07fF
C27 a_280_214# a_290_206# 0.07fF
C28 a_368_n101# a_381_n117# 0.22fF
C29 vdd a_55_n117# 0.13fF
C30 a_48_392# a_110_121# 0.10fF
C31 vdd up 0.22fF
C32 a_588_n95# a_529_n95# 0.04fF
C33 a_159_n115# a_198_n115# 0.06fF
C34 vdd a_42_n72# 0.58fF
C35 vdd a_78_19# 0.25fF
C36 up a_289_251# 0.04fF
C37 vdd a_257_230# 0.01fF
C38 w_251_224# cp 0.04fF
C39 a_588_n95# a_551_n95# 0.17fF
C40 a_43_336# a_43_86# 0.07fF
C41 a_n4_n115# a_45_n115# 0.02fF
C42 a_110_121# a_48_36# 0.10fF
C43 a_66_123# a_74_121# 0.17fF
C44 a_n4_n115# a_35_n115# 0.06fF
C45 a_349_n117# a_361_n115# 0.95fF
C46 a_18_336# a_48_392# 0.02fF
C47 a_322_n115# fout 0.14fF
C48 vdd a_371_n115# 0.13fF
C49 vdd a_588_n95# 0.19fF
C50 a_159_n115# a_218_n117# 0.02fF
C51 vdd a_42_n101# 0.37fF
C52 w_251_224# up 0.19fF
C53 vdd a_74_227# 0.27fF
C54 a_159_n115# a_205_n72# 0.14fF
C55 a_186_n117# a_198_n115# 0.95fF
C56 vdd m2_160_57# 0.09fF
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
C191 a_567_n95# a_529_n95# 0.04fF
C192 vdd a_23_n117# 0.13fF
C193 vdd a_18_19# 0.25fF
C194 up a_280_251# 0.02fF
C195 vdd dn 0.34fF
C196 a_567_n95# a_551_n95# 0.17fF
C197 a_43_336# a_74_227# 0.01fF
C198 a_529_n95# cp 0.14fF
C199 a_n4_n115# fvco_8 0.10fF
C200 m2_160_57# gnd 0.03fF **FLOATING
C201 a_551_n95# gnd 0.09fF
C202 a_609_n95# gnd 0.47fF
C203 a_588_n95# gnd 0.23fF
C204 a_567_n95# gnd 0.39fF
C205 a_546_n95# gnd 0.39fF
C206 a_529_n95# gnd 0.41fF
C207 a_368_n101# gnd 0.85fF
C208 a_381_n117# gnd 0.70fF
C209 a_371_n115# gnd 0.27fF
C210 fout gnd 1.68fF
C211 a_361_n115# gnd 1.06fF
C212 a_349_n117# gnd 0.71fF
C213 a_322_n115# gnd 0.57fF
C214 a_205_n101# gnd 0.85fF
C215 a_218_n117# gnd 0.70fF
C216 a_208_n115# gnd 0.27fF
C217 a_205_n72# gnd 1.82fF
C218 a_198_n115# gnd 1.06fF
C219 a_186_n117# gnd 0.71fF
C220 a_159_n115# gnd 0.57fF
C221 a_42_n101# gnd 0.85fF
C222 a_55_n117# gnd 0.70fF
C223 a_45_n115# gnd 0.27fF
C224 a_42_n72# gnd 1.82fF
C225 a_35_n115# gnd 1.06fF
C226 a_23_n117# gnd 0.71fF
C227 a_n4_n115# gnd 0.57fF
C228 a_102_19# gnd 0.73fF
C229 a_78_19# gnd 0.78fF
C230 a_48_36# gnd 1.59fF
C231 a_18_19# gnd 0.83fF
C232 fvco_8 gnd 2.17fF
C233 a_74_121# gnd 0.80fF
C234 a_290_206# gnd 0.23fF
C235 a_280_214# gnd 0.27fF
C236 a_264_214# gnd 0.22fF
C237 cp gnd 4.86fF
C238 dn gnd 1.24fF
C239 a_289_251# gnd 0.08fF
C240 a_264_251# gnd 0.15fF
C241 a_280_251# gnd 0.26fF
C242 a_43_86# gnd 1.99fF
C243 a_66_123# gnd 1.82fF
C244 a_74_227# gnd 0.80fF
C245 up gnd 1.05fF
C246 a_110_121# gnd 2.65fF
C247 a_66_299# gnd 1.69fF
C248 a_102_336# gnd 0.73fF
C249 a_78_336# gnd 0.78fF
C250 a_43_336# gnd 1.80fF
C251 fin gnd 0.51fF
C252 a_48_392# gnd 1.59fF
C253 a_18_336# gnd 0.83fF
C254 w_251_224# gnd 3.65fF
C255 vdd gnd 41.83fF


****************************
C1 cp 0 25p
C2 N003 0 55p
R1 cp N003 500

********************************

V1 fin 0 PULSE 0 1.8 1n 60p 60p 100n 200n
V2 vdd gnd 1.8

********************************


.tran .1n 10u uic
*.tran .1n 25u 24.5u uic
*.ic V(vin_vco) = 0
.control
run
plot V(fin)+8 V(fvco_8)+8 V(up)+6 V(dn)+4 V(cp)+2 V(fout)
plot V(up)+4 V(dn)+2 V(fin) V(fvco_8)
plot V(up)+4 V(dn)+2 V(fin) V(fout)
plot V(cp)

*plot V(N002)
*plot V(Vin_vco)
*plot V(f_out)
.endc
.end
